LinuXperia/growbox-open-motion-mobo/PCB/gantry-controller-prototype-DUE/gantry-controller-prototype-DUE3.png

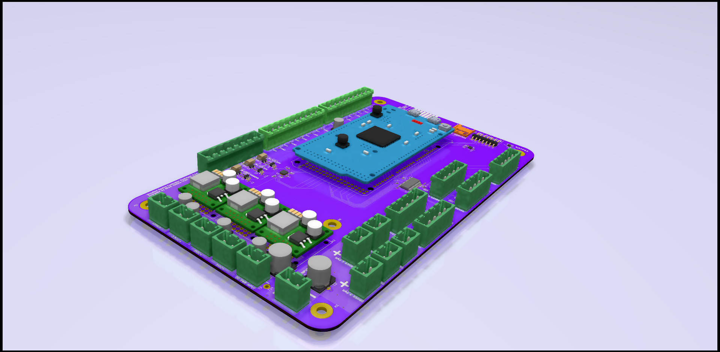
PCB/gantry-controller-prototype-DUE/gantry-controller-prototype-DUE3.png
