LinuXperia/growbox-open-motion-mobo/README.md

# growbox-open-motion-mobo
A general purpose open source Arduino DUE based motion controller designed to run the Synthetos G2 motion control fimware 

Created and designed by Adam Vadala-Roth

https://hackaday.io/adamjvr

https://github.com/adamjvr
