LinuXperia/growbox-open-motion-mobo/PCB/gantry-controller-prototype-DUE/gantry-controller-prototype-DUE.png

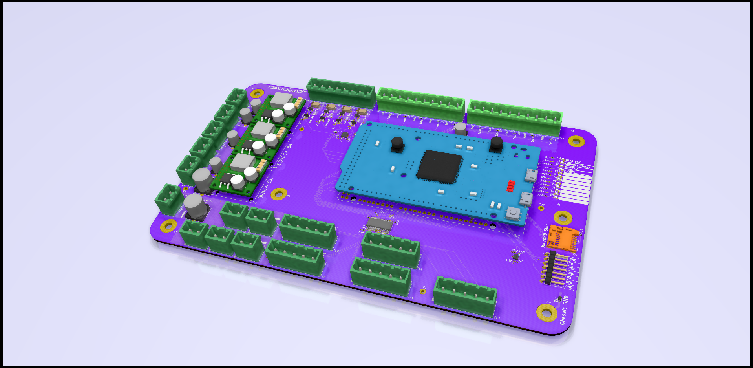
PCB/gantry-controller-prototype-DUE/gantry-controller-prototype-DUE.png
