LinuXperia/growbox-open-motion-mobo/PCB/gantry-controller-prototype-DUE/GCB_Margin.dxf

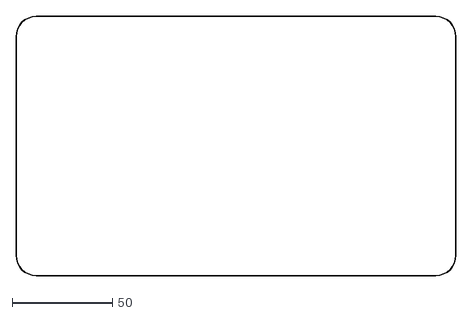
[picture p4: CAD file, 2020-06-16]
PCB/gantry-controller-prototype-DUE/GCB_Margin.dxf
219.0 x 129.0
