LinuXperia/growbox-open-motion-mobo/PCB/gantry-controller-prototype-DUE/GCB.dxf

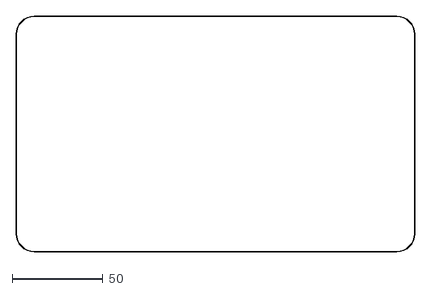
[picture p5: CAD file, 2020-06-16]
PCB/gantry-controller-prototype-DUE/GCB.dxf
220.0 x 130.0
