LinuXperia/growbox-open-motion-mobo/PCB/gantry-controller-prototype-DUE/gantry-controller-prototype-DUE.kicad_pcb

## KiCad design PCB/gantry-controller-prototype-DUE/gantry-controller-prototype-DUE.kicad_pcb (2020-06-17)

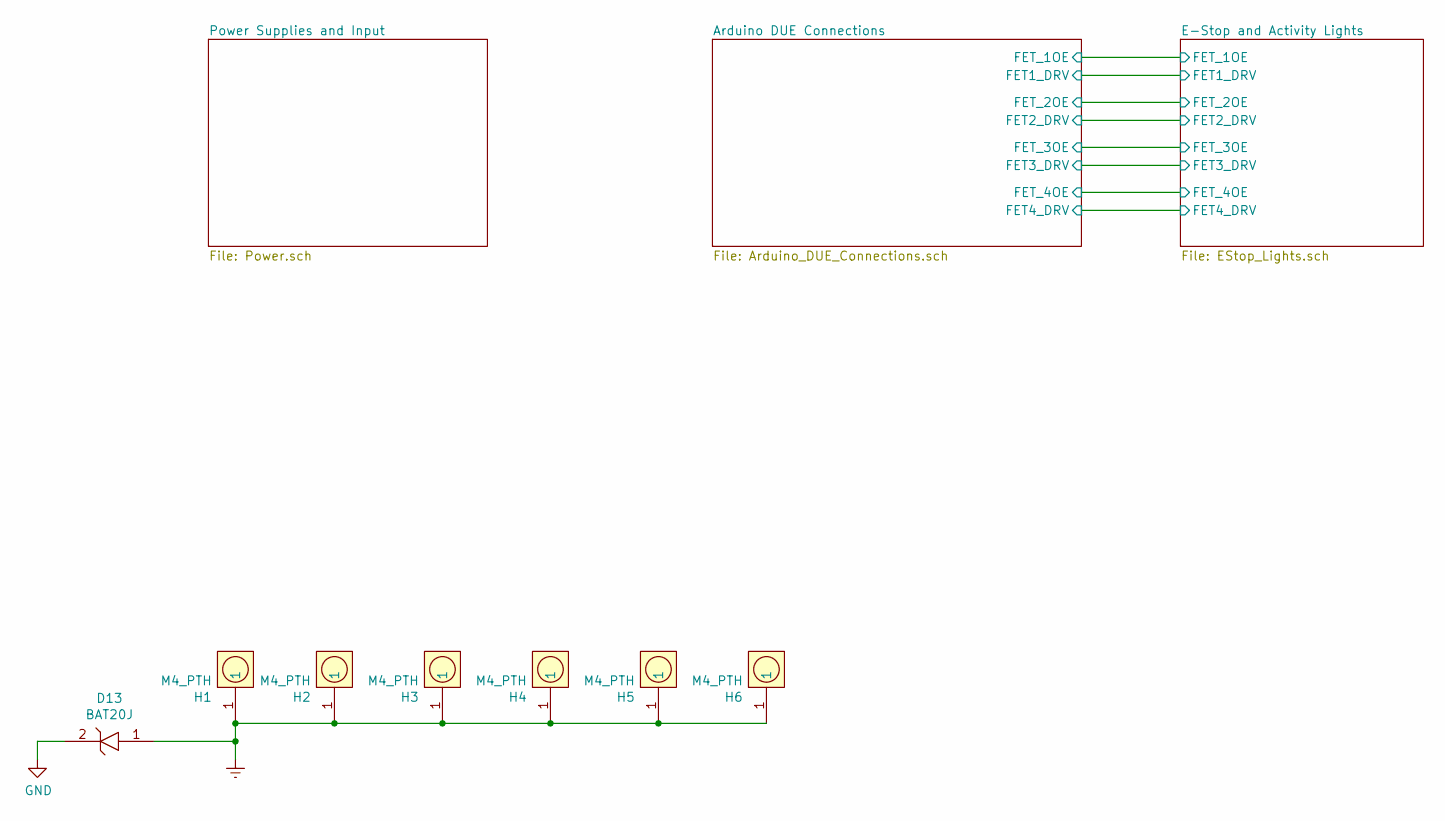
[picture p6: schematic gantry-controller-prototype-DUE.sch]

Parts:
D13: BAT20JFILM; Tolerance *; Voltage 23V; MFR# BAT20JFILM
H1, H2, H3, H4, H5, H6: M4_PTH; M4_HOLE; Tolerance *; Voltage *; MFR# *

Connections:
Earth: D13.1, H1.1, H2.1, H3.1, H4.1, H5.1, H6.1
GND: D13.2; also elsewhere on the board

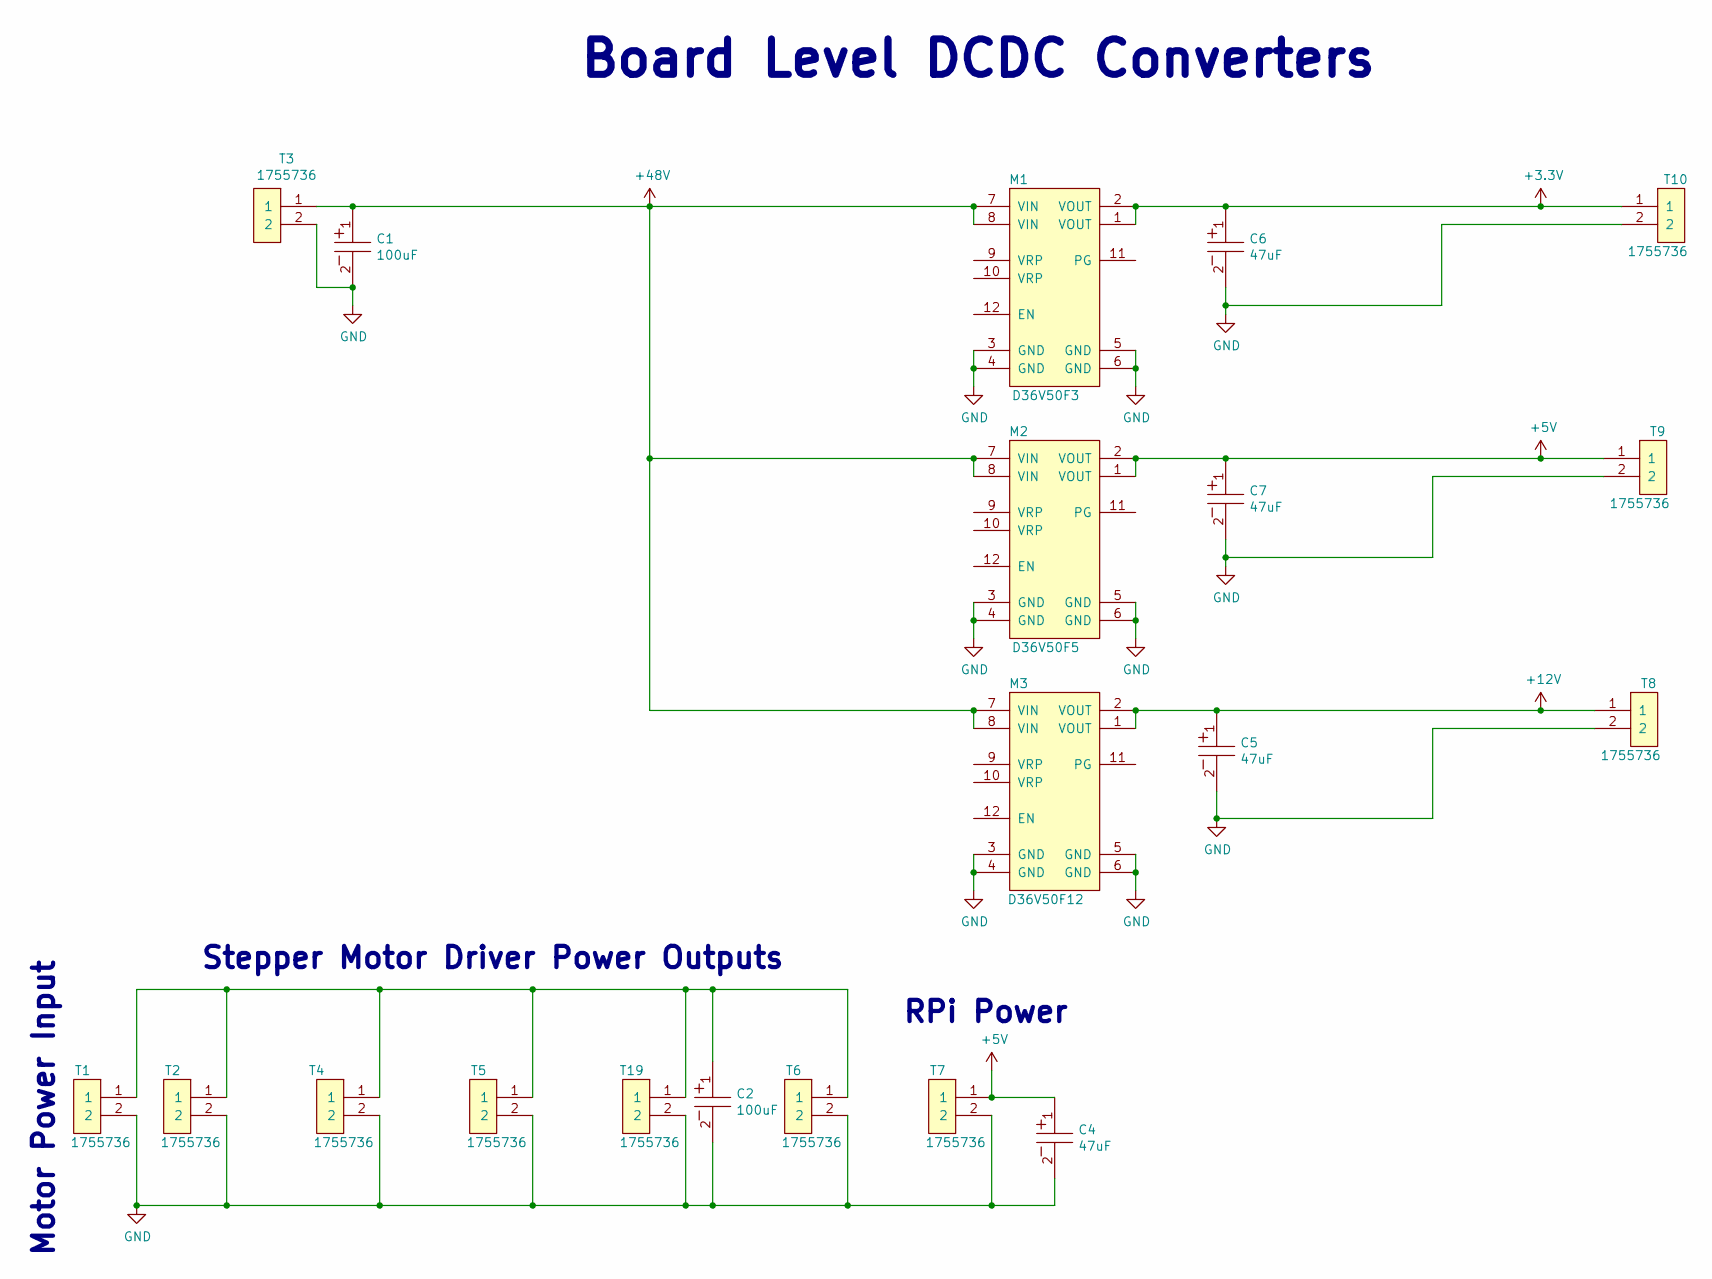
[picture p7: schematic Power.sch]

Parts:
C1, C2: UUX1J101MNL1GS; Tolerance 20%; Voltage 63V; MFR# UUX1J101MNL1GS
C4, C5, C6, C7: UWT1H470MCL1GS; Tolerance 20%; Voltage 63V; MFR# UWT1H470MCL1GS
M1: D36V50F3; D36V50Fx; Tolerance *; Voltage 50V In 3.3V OUT; MFR# D36V50F3
M2: D36V50F5; D36V50Fx; Tolerance *; Voltage 50V In 5V OUT; MFR# D36V50F5
M3: D36V50F12; D36V50Fx; Tolerance *; Voltage 50V In 12V OUT; MFR# D36V50F12
T1, T2, T3, T4, T5, T6, T7, T8, T9, T10, T19: 1755736; PhoenixContact_MSTBVA-G_02x5.08mm_Vertical; Tolerance *; Voltage 300V; MFR# 1755736

Connections:
+3V3: C6.1, M1.1 (VOUT), M1.2 (VOUT), T10.1; also elsewhere on the board
+5V: C4.1, C7.1, M2.1 (VOUT), M2.2 (VOUT), T7.1, T9.1; also elsewhere on the board
+12V: C5.1, M3.1 (VOUT), M3.2 (VOUT), T8.1; also elsewhere on the board
+48V: C1.1, M1.7 (VIN), M1.8 (VIN), M2.7 (VIN), M2.8 (VIN), M3.7 (VIN), M3.8 (VIN), T3.1
GND: C1.2, C2.2, C4.2, C5.2, C6.2, C7.2, M1.3 (GND), M1.4 (GND), M1.5 (GND), M1.6 (GND), M2.3 (GND), M2.4 (GND), M2.5 (GND), M2.6 (GND), M3.3 (GND), M3.4 (GND), M3.5 (GND), M3.6 (GND), T1.2, T2.2, T3.2, T4.2, T5.2, T6.2, T7.2, T8.2, T9.2, T10.2, T19.2; also elsewhere on the board
unnamed: C2.1, T1.1, T2.1, T4.1, T5.1, T6.1, T19.1

Notes on the sheet:
Board Level DCDC Converters
Stepper Motor Driver Power Outputs
RPi Power
Motor Power Input

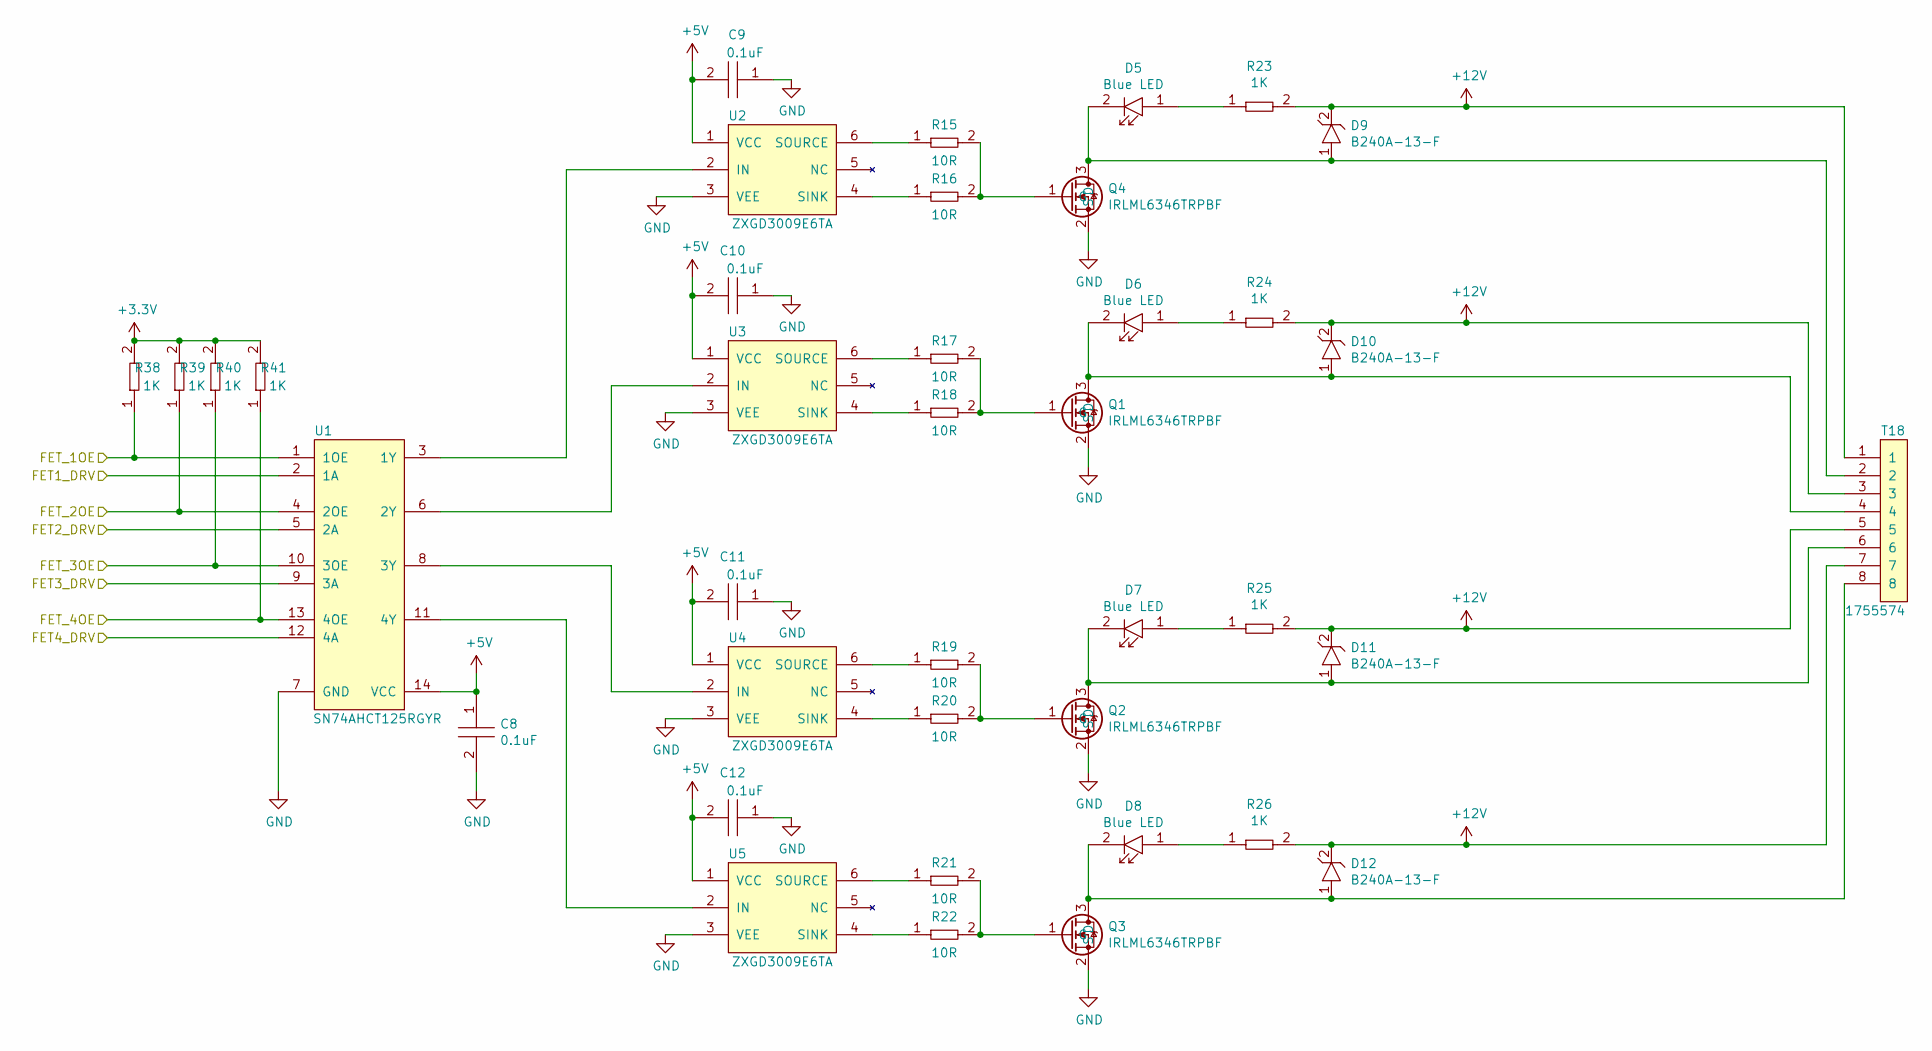
[picture p8: schematic EStop_Lights.sch]

Parts:
C8, C9, C10, C11, C12: GRM155R71E104KE14J; C0402; Tolerance 10%; Voltage 25V; MFR# GRM155R71E104KE14J
D5, D6, D7, D8: LTST-C194TBKT; LED0603; Tolerance *; Voltage 3.3V; MFR# LTST-C194TBKT
D9, D10, D11, D12: B240A-13-F; Tolerance *; Voltage 40V; MFR# B240A-13-F
Q1, Q2, Q3, Q4: IRLML6346TRPBF; SOT-23; Tolerance *; Voltage 30V; MFR# IRLML6346TRPBF
R15, R16, R17, R18, R19, R20, R21, R22: RC0402FR-0710RL; R0402; Tolerance 1%; Voltage *; MFR# RC0402FR-0710RL
R23, R24, R25, R26, R38, R39, R40, R41: RC0402FR-071KL; R0402; Tolerance 1%; Voltage *; MFR# RC0402FR-071KL
T18: 1755574; PhoenixContact_MSTBVA-G_08x5.00mm_Vertical; Tolerance *; Voltage 300V; MFR# 1755574
U1: SN74AHCT125RGYR; Tolerance *; Voltage 5V; MFR# SN74AHCT125RGYR
U2, U3, U4, U5: ZXGD3009E6TA; SOT-23-6_Handsoldering; Tolerance *; Voltage 40V; MFR# ZXGD3009E6TA

Connections:
+3V3: R38.2, R39.2, R40.2, R41.2; also elsewhere on the board
+5V: C8.1, C9.2, C10.2, C11.2, C12.2, U1.14 (VCC), U2.1 (VCC), U3.1 (VCC), U4.1 (VCC), U5.1 (VCC); also elsewhere on the board
+12V: D9.2, D10.2, D11.2, D12.2, R23.2, R24.2, R25.2, R26.2, T18.1, T18.3, T18.5, T18.7; also elsewhere on the board
/Arduino DUE Connections/FET1_DRV: U1.2 (1A); also elsewhere on the board
/Arduino DUE Connections/FET2_DRV: U1.5 (2A); also elsewhere on the board
/Arduino DUE Connections/FET3_DRV: U1.9 (3A); also elsewhere on the board
/Arduino DUE Connections/FET4_DRV: U1.12 (4A); also elsewhere on the board
/Arduino DUE Connections/FET_1OE: R38.1, U1.1 (1OE); also elsewhere on the board
/Arduino DUE Connections/FET_2OE: R39.1, U1.4 (2OE); also elsewhere on the board
/Arduino DUE Connections/FET_3OE: R40.1, U1.10 (3OE); also elsewhere on the board
/Arduino DUE Connections/FET_4OE: R41.1, U1.13 (4OE); also elsewhere on the board
GND: C8.2, C9.1, C10.1, C11.1, C12.1, Q1.2 (S), Q2.2 (S), Q3.2 (S), Q4.2 (S), U1.7 (GND), U2.3 (VEE), U3.3 (VEE), U4.3 (VEE), U5.3 (VEE); also elsewhere on the board
unnamed: D5.1, R23.1
unnamed: D5.2, D9.1, Q4.3 (D), T18.2
unnamed: D6.1, R24.1
unnamed: D7.1, R25.1
unnamed: D8.1, R26.1
unnamed: D6.2, D10.1, Q1.3 (D), T18.4
unnamed: D7.2, D11.1, Q2.3 (D), T18.6
unnamed: D8.2, D12.1, Q3.3 (D), T18.8
unnamed: Q1.1 (G), R17.2, R18.2
unnamed: Q2.1 (G), R19.2, R20.2
unnamed: Q3.1 (G), R21.2, R22.2
unnamed: Q4.1 (G), R15.2, R16.2
unnamed: R15.1, U2.6 (SOURCE)
unnamed: R16.1, U2.4 (SINK)
unnamed: R17.1, U3.6 (SOURCE)
unnamed: R18.1, U3.4 (SINK)
unnamed: R19.1, U4.6 (SOURCE)
unnamed: R20.1, U4.4 (SINK)
unnamed: R21.1, U5.6 (SOURCE)
unnamed: R22.1, U5.4 (SINK)
unnamed: U1.3 (1Y), U2.2 (IN)
unnamed: U1.6 (2Y), U3.2 (IN)
unnamed: U1.8 (3Y), U4.2 (IN)
unnamed: U1.11 (4Y), U5.2 (IN)

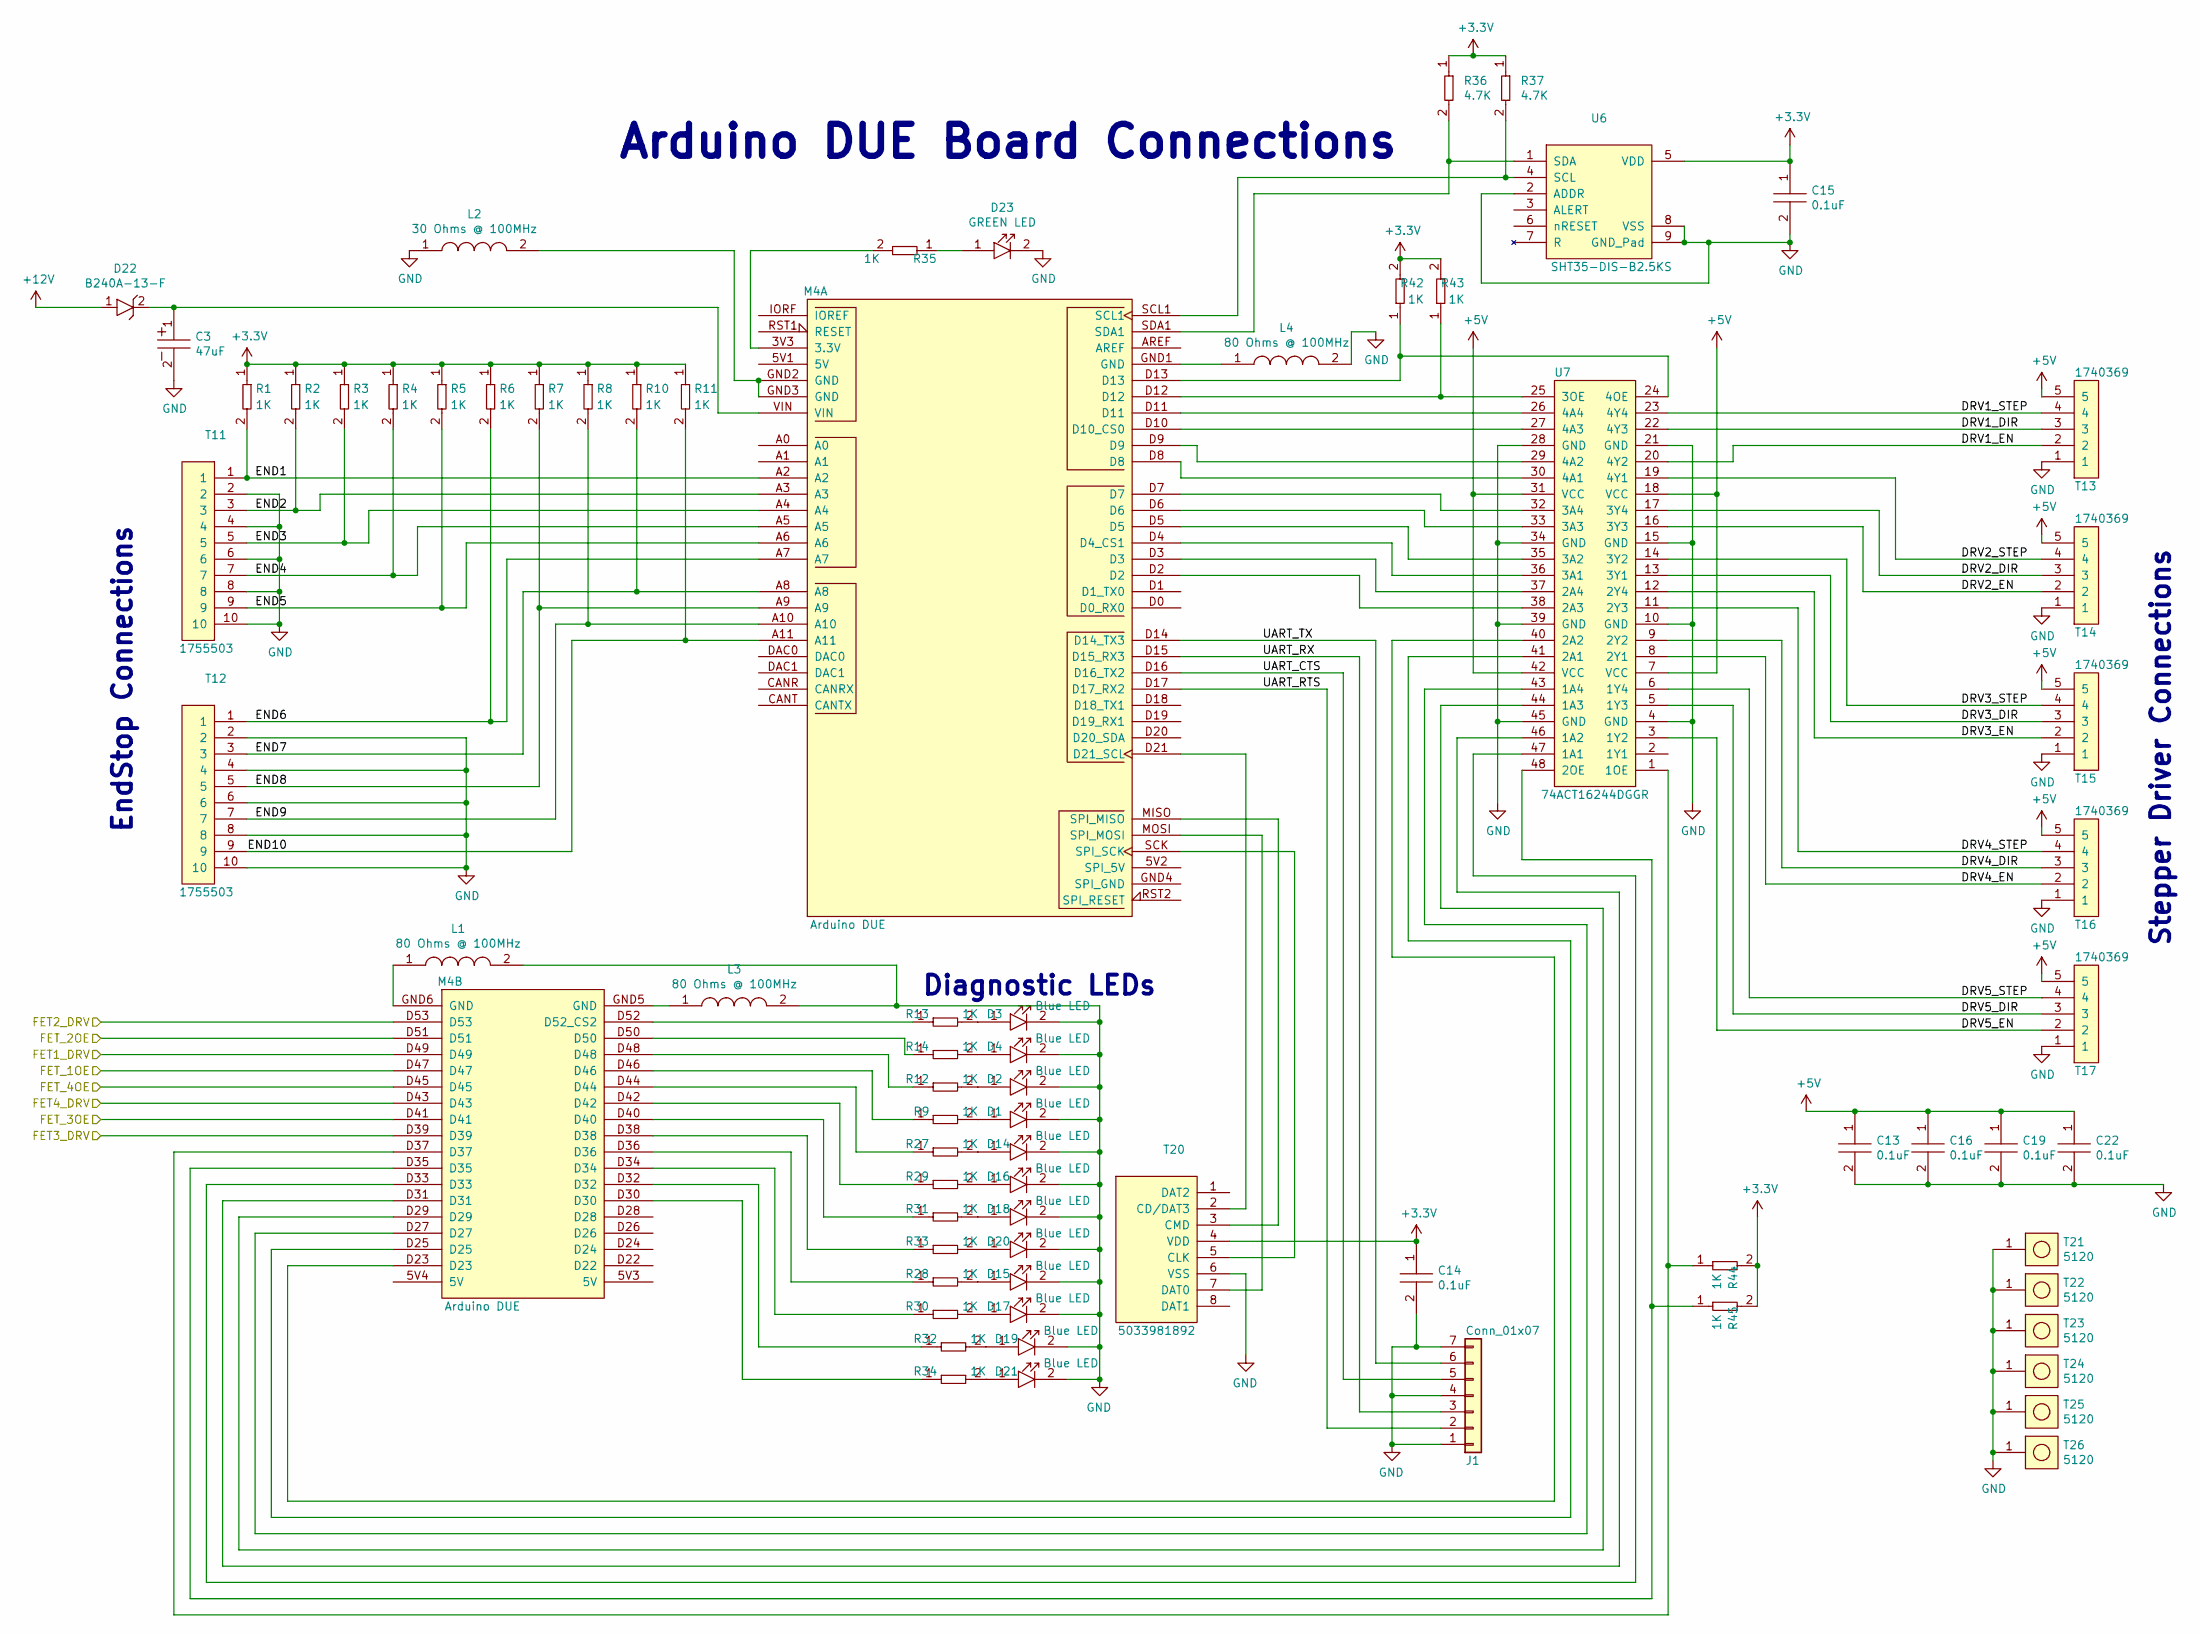
[picture p9: schematic Arduino_DUE_Connections.sch]

Parts:
C3: UWT1H470MCL1GS; Tolerance 20%; Voltage 63V; MFR# UWT1H470MCL1GS
C13, C14, C15, C16, C19, C22: GRM155R71E104KE14J; C0402; Tolerance 10%; Voltage 25V; MFR# GRM155R71E104KE14J
D1, D2, D3, D4, D14, D15, D16, D17, D18, D19, D20, D21: LTST-C194TBKT; LED0603; Tolerance *; Voltage 3.3V; MFR# LTST-C194TBKT
D22: B240A-13-F; Tolerance *; Voltage 40V; MFR# B240A-13-F
D23: LTST-C194KGKT; LED0603; Tolerance *; Voltage 2.1V; MFR# LTST-C194KGKT
J1: Conn_01x07; Pin_Header_Angled_1x07_Pitch2.54mm
L1, L3, L4: MH1608-800Y; I0603; Tolerance *; Voltage *; MFR# Bourns Inc.
L2: MH2029-300Y; Tolerance *; Voltage *; MFR# Bourns Inc.
M4: Arduino_DUE_Shield_TEMP; Arduino_Due_Shield; Tolerance *; Voltage *; MFR# *
R1, R2, R3, R4, R5, R6, R7, R8, R9, R10, R11, R12, R13, R14, R27, R28, R29, R30, R31, R32, R33, R34, R35, R42, R43, R44, R45: RC0402FR-071KL; R0402; Tolerance 1%; Voltage *; MFR# RC0402FR-071KL
R36, R37: RC0402FR-074K7L; R0402; Tolerance 1%; Voltage *; MFR# RC0402FR-074K7L
T11, T12: 1755503; PhoenixContact_MSTBVA-G_10x5.00mm_Vertical; Tolerance *; Voltage 300V; MFR# 1755503
T13, T14, T15, T16, T17: 1740369; PhoenixContact_MSTBVA-G_05x5.00mm_Vertical; Tolerance *; Voltage 300V; MFR# 1740369
T20: 5033981892; MOLEX_503398-1892; Tolerance *; Voltage 3.3V; MFR# 5033981892
T21, T22, T23, T24, T25, T26: 5120; Tolerance *; Voltage *; MFR# 5120
U6: SHT35-DIS-B2.5KS; DFN8_SHT35; Tolerance *; Voltage 2.15V-5.5V; MFR# SHT35-DIS-B2.5KS
U7: 74ACT16244DGGR; Tolerance *; Voltage 4.5V ~ 5.5V; MFR# 74ACT16244DGGR

Connections:
+3V3: C14.1, C15.1, R1.1, R2.1, R3.1, R4.1, R5.1, R6.1, R7.1, R8.1, R10.1, R11.1, R36.1, R37.1, R42.2, R43.2, R44.2, R45.2, T20.4 (VDD), U6.5 (VDD); also elsewhere on the board
+5V: C13.1, C16.1, C19.1, C22.1, T13.5, T14.5, T15.5, T16.5, T17.5, U7.7 (VCC), U7.18 (VCC), U7.31 (VCC), U7.42 (VCC); also elsewhere on the board
+12V: D22.1; also elsewhere on the board
/Arduino DUE Connections/DRV1_DIR: T13.3, U7.22 (4Y3)
/Arduino DUE Connections/DRV1_EN: T13.2, U7.20 (4Y2)
/Arduino DUE Connections/DRV1_STEP: T13.4, U7.23 (4Y4)
/Arduino DUE Connections/DRV2_DIR: T14.3, U7.17 (3Y4)
/Arduino DUE Connections/DRV2_EN: T14.2, U7.16 (3Y3)
/Arduino DUE Connections/DRV2_STEP: T14.4, U7.19 (4Y1)
/Arduino DUE Connections/DRV3_DIR: T15.3, U7.13 (3Y1)
/Arduino DUE Connections/DRV3_EN: T15.2, U7.12 (2Y4)
/Arduino DUE Connections/DRV3_STEP: T15.4, U7.14 (3Y2)
/Arduino DUE Connections/DRV4_DIR: T16.3, U7.9 (2Y2)
/Arduino DUE Connections/DRV4_EN: T16.2, U7.8 (2Y1)
/Arduino DUE Connections/DRV4_STEP: T16.4, U7.11 (2Y3)
/Arduino DUE Connections/DRV5_DIR: T17.3, U7.5 (1Y3)
/Arduino DUE Connections/DRV5_EN: T17.2, U7.3 (1Y2)
/Arduino DUE Connections/DRV5_STEP: T17.4, U7.6 (1Y4)
/Arduino DUE Connections/END1: M4.A2, R1.2, T11.1
/Arduino DUE Connections/END2: M4.A3, R2.2, T11.3
/Arduino DUE Connections/END3: M4.A4, R3.2, T11.5
/Arduino DUE Connections/END4: M4.A5, R4.2, T11.7
/Arduino DUE Connections/END5: M4.A6, R5.2, T11.9
/Arduino DUE Connections/END6: M4.A7, R6.2, T12.1
/Arduino DUE Connections/END7: M4.A8, R10.2, T12.3
/Arduino DUE Connections/END8: M4.A9, R7.2, T12.5
/Arduino DUE Connections/END9: M4.A10, R8.2, T12.7
/Arduino DUE Connections/END10: M4.A11, R11.2, T12.9
/Arduino DUE Connections/FET1_DRV: M4.D49; also elsewhere on the board
/Arduino DUE Connections/FET2_DRV: M4.D53; also elsewhere on the board
/Arduino DUE Connections/FET3_DRV: M4.D39; also elsewhere on the board
/Arduino DUE Connections/FET4_DRV: M4.D43; also elsewhere on the board
/Arduino DUE Connections/FET_1OE: M4.D47; also elsewhere on the board
/Arduino DUE Connections/FET_2OE: M4.D51; also elsewhere on the board
/Arduino DUE Connections/FET_3OE: M4.D41; also elsewhere on the board
/Arduino DUE Connections/FET_4OE: M4.D45; also elsewhere on the board
/Arduino DUE Connections/UART_CTS: J1.5, M4.D16 (D16_TX2)
/Arduino DUE Connections/UART_RTS: J1.2, M4.D17 (D17_RX2)
/Arduino DUE Connections/UART_RX: J1.3, M4.D15 (D15_RX3)
/Arduino DUE Connections/UART_TX: J1.6, M4.D14 (D14_TX3)
GND: C3.2, C13.2, C14.2, C15.2, C16.2, C19.2, C22.2, D1.2, D2.2, D3.2, D4.2, D14.2, D15.2, D16.2, D17.2, D18.2, D19.2, D20.2, D21.2, D23.2, J1.1, J1.4, J1.7, L1.2, L2.1, L3.2, L4.2, T11.2, T11.4, T11.6, T11.8, T11.10, T12.2, T12.4, T12.6, T12.8, T12.10, T13.1, T14.1, T15.1, T16.1, T17.1, T20.6 (VSS), T21.1, T22.1, T23.1, T24.1, T25.1, T26.1, U6.2 (ADDR), U6.8 (VSS), U6.9 (GND_Pad), U7.4 (GND), U7.10 (GND), U7.15 (GND), U7.21 (GND), U7.28 (GND), U7.34 (GND), U7.39 (GND), U7.45 (GND); also elsewhere on the board
unnamed: C3.1, D22.2, M4.VIN
unnamed: D1.1, R9.2
unnamed: D2.1, R12.2
unnamed: D3.1, R13.2
unnamed: D4.1, R14.2
unnamed: D14.1, R27.2
unnamed: D15.1, R28.2
unnamed: D16.1, R29.2
unnamed: D17.1, R30.2
unnamed: D18.1, R31.2
unnamed: D19.1, R32.2
unnamed: D20.1, R33.2
unnamed: D21.1, R34.2
unnamed: D23.1, R35.1
unnamed: L1.1, M4.GND6 (GND)
unnamed: L2.2, M4.GND2 (GND), M4.GND3 (GND)
unnamed: L3.1, M4.GND5 (GND)
unnamed: L4.1, M4.GND1 (GND)
unnamed: M4.3V3 (3.3V), R35.2
unnamed: M4.D2, U7.38 (2A3)
unnamed: M4.D3, U7.37 (2A4)
unnamed: M4.D4 (D4_CS1), U7.36 (3A1)
unnamed: M4.D5, U7.35 (3A2)
unnamed: M4.D6, U7.33 (3A3)
unnamed: M4.D7, U7.32 (3A4)
unnamed: M4.D8, U7.30 (4A1)
unnamed: M4.D9, U7.29 (4A2)
unnamed: M4.D10 (D10_CS0), U7.27 (4A3)
unnamed: M4.D11, U7.26 (4A4)
unnamed: M4.D12, R43.1, U7.25 (3OE)
unnamed: M4.D13, R42.1, U7.24 (4OE)
unnamed: M4.D21 (D21_SCL), T20.2 (CD/DAT3)
unnamed: M4.D23, U7.40 (2A2)
unnamed: M4.D25, U7.41 (2A1)
unnamed: M4.D27, U7.43 (1A4)
unnamed: M4.D29, U7.44 (1A3)
unnamed: M4.D30, R34.1
unnamed: M4.D31, U7.46 (1A2)
unnamed: M4.D32, R32.1
unnamed: M4.D33, U7.47 (1A1)
unnamed: M4.D34, R30.1
unnamed: M4.D35, R45.1, U7.48 (2OE)
unnamed: M4.D36, R28.1
unnamed: M4.D37, R44.1, U7.1 (1OE)
unnamed: M4.D38, R33.1
unnamed: M4.D40, R31.1
unnamed: M4.D42, R29.1
unnamed: M4.D44, R27.1
unnamed: M4.D46, R9.1
unnamed: M4.D48, R12.1
unnamed: M4.D50, R14.1
unnamed: M4.D52 (D52_CS2), R13.1
unnamed: M4.MISO (SPI_MISO), T20.3 (CMD)
unnamed: M4.MOSI (SPI_MOSI), T20.7 (DAT0)
unnamed: M4.SCK (SPI_SCK), T20.5 (CLK)
unnamed: M4.SCL1, R37.2, U6.4 (SCL)
unnamed: M4.SDA1, R36.2, U6.1 (SDA)

Notes on the sheet:
Arduino DUE Board Connections
EndStop Connections
Diagnostic LEDs
Stepper Driver Connections

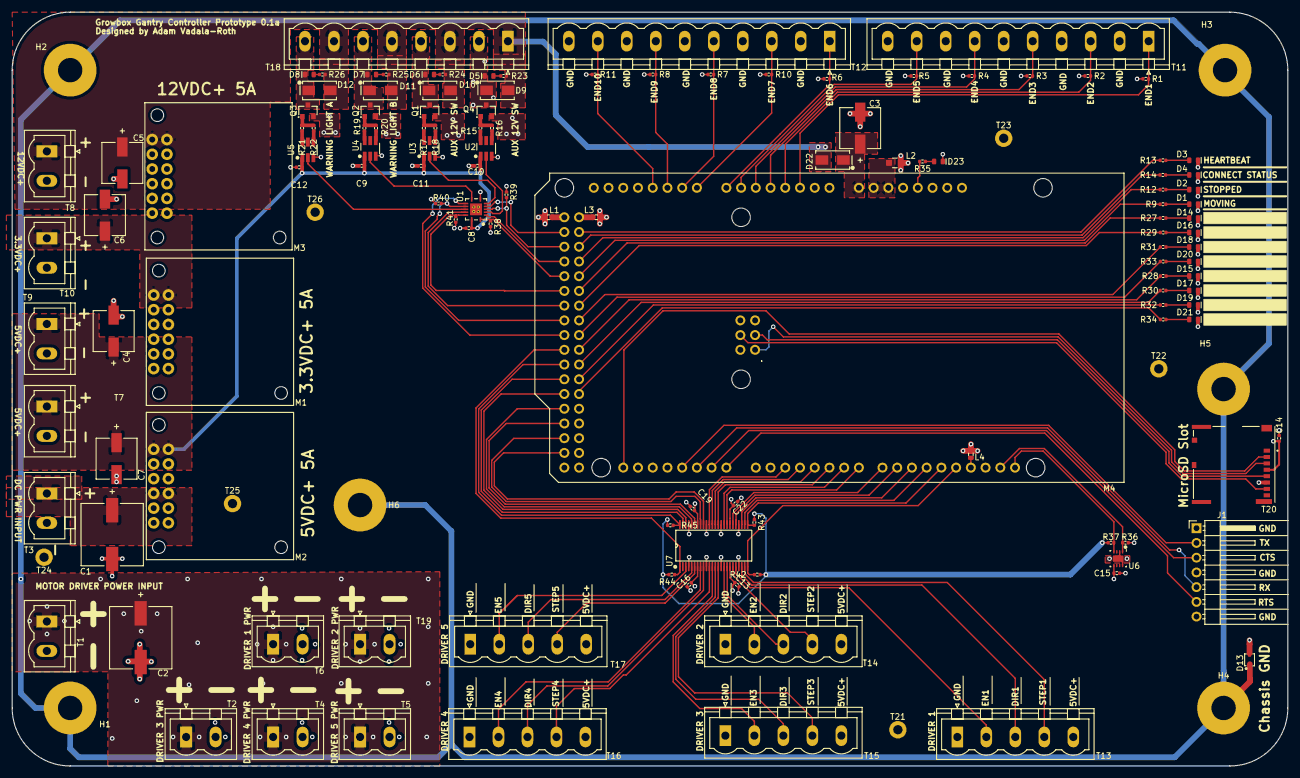
[picture p10: board gantry-controller-prototype-DUE.kicad_pcb from above]

Board: 4 copper layers, 220.0 x 130.0 mm, 138 parts (0 on the bottom side), 125 nets.
