LinuXperia/growbox-open-motion-mobo/(commit log)

2020-06-16 Release
    Open Source release of internal development motion control hardware.
    [Arduino_DUE_Connections.sch, EStop_Lights.sch, GCB.dxf, GCB_Margin.dxf, Power.sch, RaspberryPi.sch, STM32_Connections.sch, gantry-controller-prototype-DUE.kicad_pcb]
2020-06-17 Fab files and edits
    made some changes to the circuit, added pullups to OE pins on 74 devices and tied mosfet drivers to GND, added fab files
    [Arduino_DUE_Connections.sch, EStop_Lights.sch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]
2020-06-17 DRC check and gerbers generated, order placed with OSHPark
    [Arduino_DUE_Connections.sch, EStop_Lights.sch, GCB.dxf, GCB_Margin.dxf, Power.sch, RaspberryPi.sch, STM32_Connections.sch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]
